theeligami/growschrank/CAD/1_growschrank.png

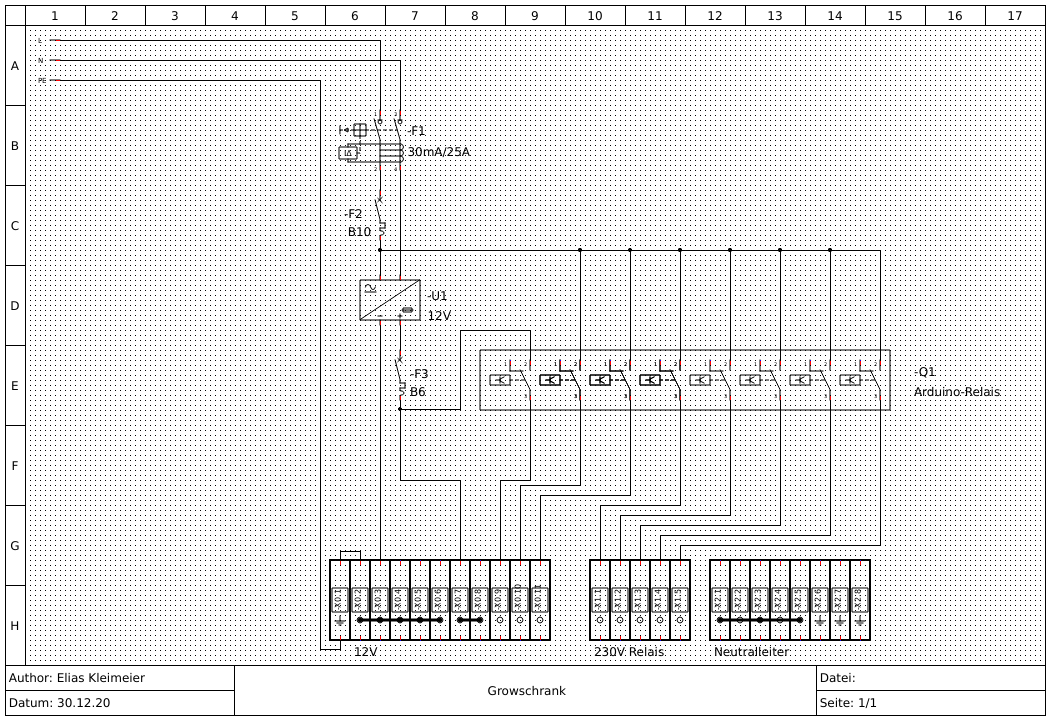
CAD/1_growschrank.png
