theeligami/growschrank/CAD/Zuleitung_Lüfter.FCStd

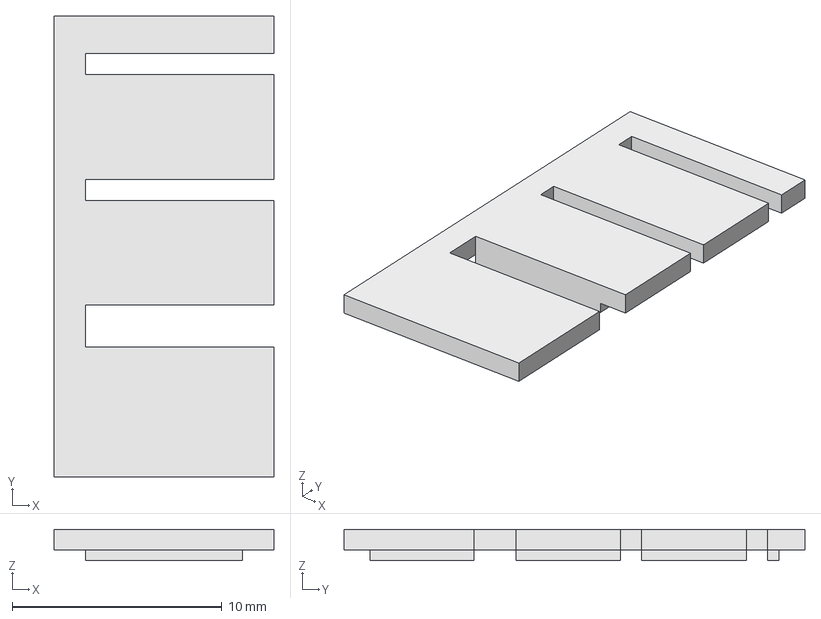
[picture p2: CAD file, 2021-11-26]
CAD/Zuleitung_Lüfter.FCStd
10.5 x 22.0 x 1.50 mm
