theeligami/growschrank/CAD/Pumpenadapter_4mm.FCStd

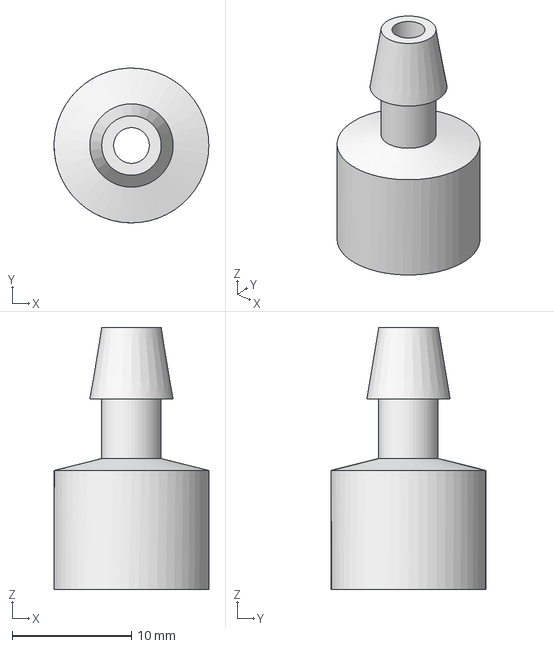
[picture p3: CAD file, 2021-10-30]
CAD/Pumpenadapter_4mm.FCStd
13.0 x 13.0 x 22.0 mm
