theeligami/growschrank/CAD/DINrail_Clip.fcstd

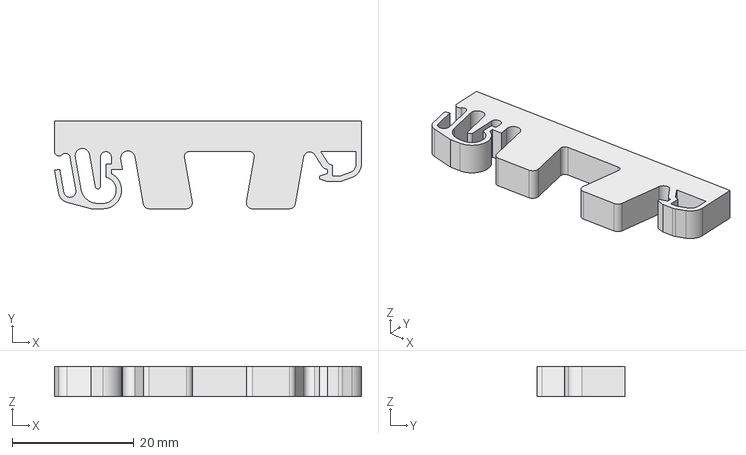
[picture p4: CAD file, 2021-01-07]
CAD/DINrail_Clip.fcstd
50.5 x 14.4 x 5.00 mm
