theeligami/growschrank/CAD/Relais.FCStd

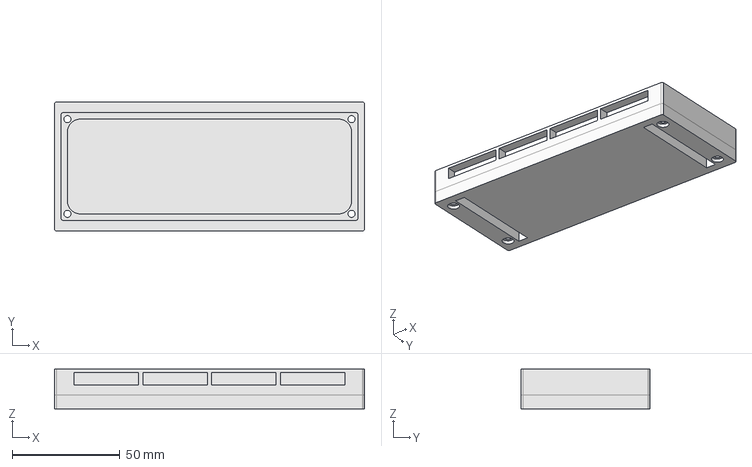
[picture p5: CAD file, 2021-01-07]
CAD/Relais.FCStd
144.0 x 60.0 x 18.5 mm
