theeligami/growschrank/(list of files, cad)

Other CAD files:
CAD/Relais.stl
