theeligami/growschrank/kicad/growschrank.kicad_pcb

## KiCad design kicad/growschrank.kicad_pcb (2021-01-07)

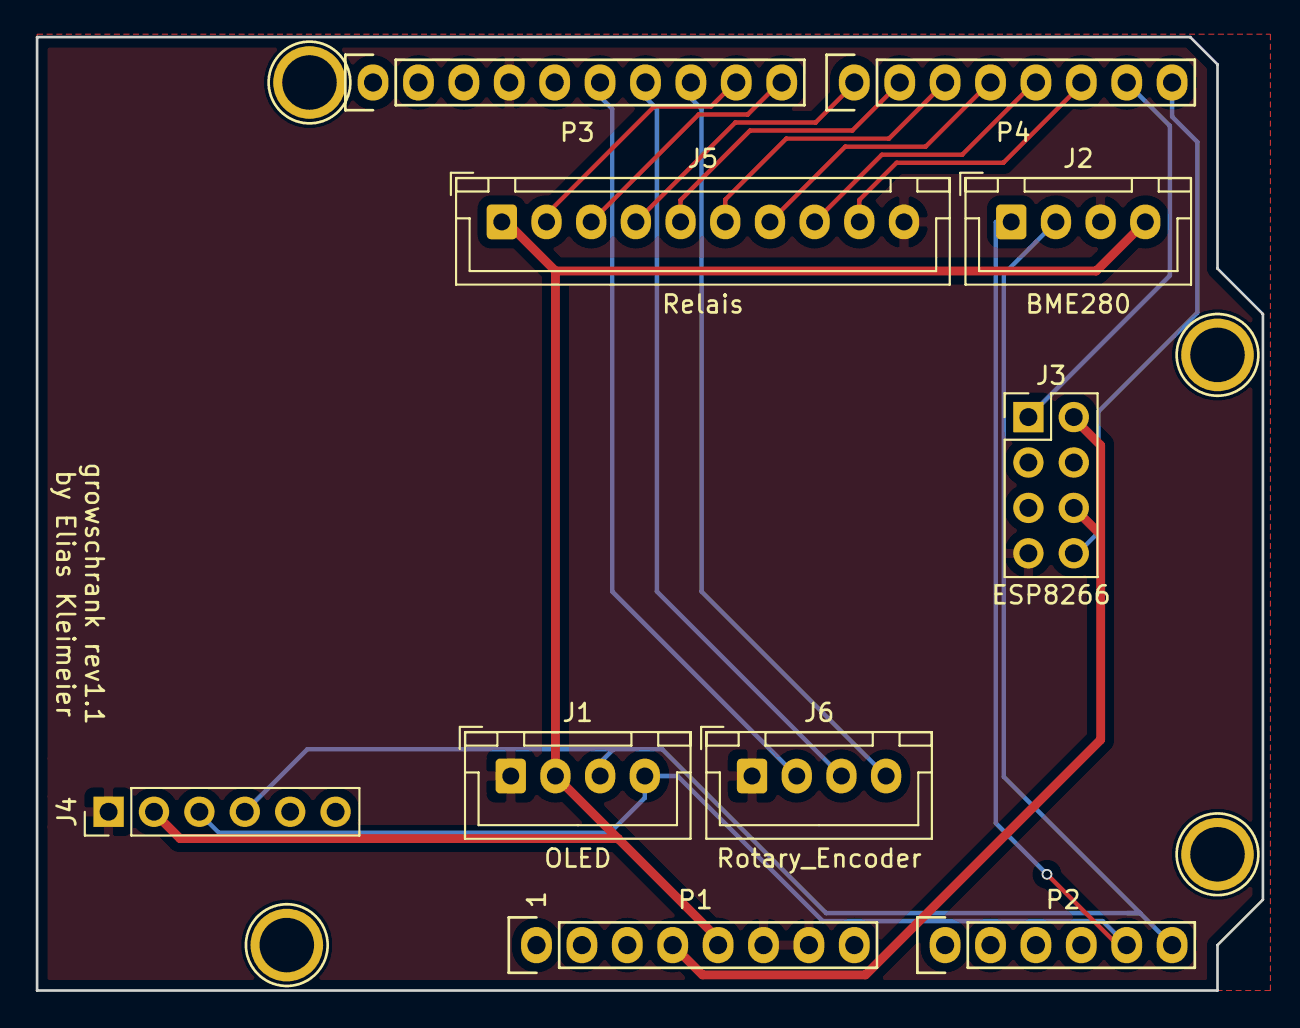
[picture p6: board growschrank.kicad_pcb from above]

Board: 2 copper layers, 68.6 x 53.3 mm, 14 parts (0 on the bottom side), 18 nets.

Parts:
J1: OLED; JST_XH_B4B-XH-A_1x04_P2.50mm_Vertical
J2: BME280; JST_XH_B4B-XH-A_1x04_P2.50mm_Vertical
J3: ESP8266; PinHeader_2x04_P2.54mm_Vertical
J4: DS3231; PinHeader_1x06_P2.54mm_Vertical
J5: Relais; JST_XH_B10B-XH-A_1x10_P2.50mm_Vertical
J6: Rotary_Encoder; JST_XH_B4B-XH-A_1x04_P2.50mm_Vertical
P1: Power; Socket_Strip_Arduino_1x08
P2: Analog; Socket_Strip_Arduino_1x06
P3: Digital; Socket_Strip_Arduino_1x10
P4: Digital; Socket_Strip_Arduino_1x08
P5, P6, P7, P8: CONN_01X01; Arduino_1pin

Connections:
+3V3: J3.2, J3.6, P1.4
+5V: J1.2, J2.4, J4.2, J5.1, P1.5
/0(Rx): J3.8, P4.8
/1(Tx): J3.1, P4.7
/2: J5.9, P4.6
/3(**): J5.8, P4.5
/4: J5.7, P4.4
/5(**): J5.6, P4.3
/6(**): J5.5, P4.2
/7: J5.4, P4.1
/8: J5.3, P3.10
/9(**): J5.2, P3.9
/10(**/SS): J6.4, P3.8
/11(**/MOSI): J6.3, P3.7
/12(MISO): J6.2, P3.6
/A4(SDA): J1.4, J2.1, J4.3, P2.5, P3.2
/A5(SCL): J1.3, J2.2, J4.4, P2.6, P3.1
GND: J1.1, J2.3, J3.7, J4.1, J5.10, J6.1, P1.6, P1.7, P3.4
