theeligami/growschrank/src/growschrank.ino

#include <Adafruit_GFX.h>
#include <Adafruit_SSD1306.h>
#include <Adafruit_Sensor.h>
#include <Adafruit_BME280.h>
#include <avr/sleep.h>
#include <DS3231.h>
#include <EEPROM.h>
#include <Wire.h>
#include <SPI.h>
#include <util/delay.h>

// Relais
#define LAMP 2
#define PUMP 3
#define RELAIS_3 4
#define RELAIS_4 5
#define RELAIS_5 6
#define RELAIS_6 7
#define RELAIS_7 8
#define FAN 9

// Rotary Encoder
#define SW  10
#define CLK  11
#define DT  12

// EEPROM
#define	LAMP_ON_ADR		0
#define LAMP_OFF_ADR	16
#define PUMP_ON_ADR		32
#define PUMP_OFF_ADR	48
#define FAN_ON_ADR		64
#define FAN_OFF_ADR		72
#define LAMP_STATE_ADR  88
#define PUMP_STATE_ADR  104

// OLED
#define SCREEN_WIDTH 128
#define SCREEN_HEIGHT 32
#define CONTRAST 0

#define ON LOW
#define OFF HIGH

Adafruit_SSD1306 display(SCREEN_WIDTH, SCREEN_HEIGHT, &Wire);

// DS3231
DS3231 Clock;
RTClib RTC;

// BME280
Adafruit_BME280 bme;

// Rotary Encoder
volatile int counter = 0;
volatile int currentStateCLK = 0;
volatile int lastStateCLK = 0;
volatile unsigned long lastSW = 0;
volatile boolean up = false, down = false;
volatile boolean swPressed = false;

// Menu
String menuItem0 = "..";	// up
String menuItem1 = "Clock";
String menuItem2 = "Lamp ON/OFF";
String menuItem3 = "Pump ON/OFF";
String menuItem4 = "Fan ON/OFF";
String menuItem5 = "Manual mode";

uint8_t menuItem = 0;
uint8_t subMenuItem = 0;
uint8_t timeItem = 0;
uint8_t page = 0;
uint8_t time[2] = {0,0};
uint8_t lampOn[2], lampOff[2];
uint8_t pumpOn[2], pumpOff[2];
uint8_t fanOn, fanOff;
boolean flag = false;

// Power saving
volatile uint64_t lastAction;
volatile boolean pwrFlag = false;

void setup()
{
  	// Start serial interface
	Serial.begin(9600);
  
  	// Start I2C Interface
  	Wire.begin();

  	// Set display
  	if (!display.begin(SSD1306_SWITCHCAPVCC, 0x3C)) // Address 0x3C for 128x32
  	{
    	Serial.println("SSD1306 allocation failed");
    	while(1);
  	}

  	display.clearDisplay();
  	display.ssd1306_command(SSD1306_SETCONTRAST);
	display.ssd1306_command(CONTRAST);
	display.setTextSize(1);
  	display.setTextColor(WHITE);
  	display.setCursor(0, 0);
  	display.println("Booting...");
  	display.display();

	// Start BME280
	while (!bme.begin(0x76, &Wire))
	{
		display.print("BME280 ERROR at ");
		display.println(bme.sensorID());
		display.display();
		_delay_ms(1000);
	}

	// Set clock to 24h
  	Clock.setClockMode(false);
	
	// Get EEPROM values
	EEPROM.get(LAMP_ON_ADR, lampOn);
	EEPROM.get(LAMP_OFF_ADR, lampOff);
	EEPROM.get(PUMP_ON_ADR, pumpOn);
	EEPROM.get(PUMP_OFF_ADR, pumpOff);
	EEPROM.get(FAN_ON_ADR, fanOn);
	EEPROM.get(FAN_OFF_ADR, fanOff);

	// Pin modes
	pinMode(CLK, INPUT_PULLUP);
  	pinMode(DT, INPUT_PULLUP);
  	pinMode(SW, INPUT_PULLUP);
  	pinMode(LAMP, OUTPUT);
  	pinMode(PUMP, OUTPUT);
  	pinMode(RELAIS_3, OUTPUT);
  	pinMode(RELAIS_4, OUTPUT);
  	pinMode(RELAIS_5, OUTPUT);
  	pinMode(RELAIS_6, OUTPUT);
  	pinMode(RELAIS_7, OUTPUT);
  	pinMode(FAN, OUTPUT);

	for (int i=2; i<9; i++)
		digitalWrite(i, OFF);

  	// Read the initial state of CLK for rotary encoder
  	lastStateCLK = digitalRead(CLK);

	lastAction = millis();

	PCICR |= (1 << PCIE0);
	PCMSK0 |= ((1 << PCINT2) | (1 << PCINT3) | (1 << PCINT4));

	// Set last state of controller e.g. after blackout
	if (EEPROM.read(LAMP_STATE_ADR)==1)
		digitalWrite(LAMP, ON);
	if (EEPROM.read(PUMP_STATE_ADR)==1)
		digitalWrite(PUMP, ON);

	display.setTextSize(1);
}

void loop()
{
	if (millis()-lastAction>=60000)
	{
		if (!pwrFlag)
			pwrFlag = true;
			display.clearDisplay();
			display.display();
	}
	else
	{
		drawMenu();
		readEncoder();
	}

	checkTimer(lampOn, lampOff, LAMP, LAMP_STATE_ADR);
	checkOnOffController(fanOn, fanOff, (uint8_t) bme.readHumidity(), FAN);
	_delay_ms(10);
}

// Draws the menu to the screen
void drawMenu()
{
	switch (page)
	{
		case 0:	// Main menu
		{
			displayMainMenuPage();
			break;
		}
		case 1:	// Settings selection menu
		{
			display.setTextSize(1);
			display.clearDisplay();
			display.setTextColor(WHITE);
			display.setCursor(0, 0);
			display.print("Main Menu");
			display.drawFastHLine(0, 10, SCREEN_WIDTH, WHITE);
			switch (menuItem)
			{
				case 0:
				{
					displayMenuItem(menuItem0, 15, true);
					displayMenuItem(menuItem1, 25, false);
					break;
				}
				case 1:
				{
					displayMenuItem(menuItem0, 15, false);
					displayMenuItem(menuItem1, 25, true);
					break;
				}
				case 2:
				{
					displayMenuItem(menuItem1, 15, false);	
					displayMenuItem(menuItem2, 25, true);
					break;
				}
				case 3:
				{
					displayMenuItem(menuItem2, 15, false);
					displayMenuItem(menuItem3, 25, true);
					break;
				}
				case 4:
				{
					displayMenuItem(menuItem3, 15, false);
					displayMenuItem(menuItem4, 25, true);
					break;
				}
				case 5:
				{
					displayMenuItem(menuItem4, 15, false);
					displayMenuItem(menuItem5, 25, true);
					break;
				}
			}
			display.display();
			break;
		}
		case 2:
		{
			switch (menuItem)
			{
				case 1:	// Clock
				{
					displayClockMenuPage(menuItem1, time);
					break;
				}
				case 2:	// Lamp time
				{
					if (!flag)
					{
						flag = true;
						EEPROM.get(LAMP_ON_ADR, lampOn);
						EEPROM.get(LAMP_OFF_ADR, lampOff);
					}
					displayTimerMenuPage(menuItem2, lampOn, lampOff);
					break;
				}
				case 3:	// Pump time
				{
					if (!flag)
					{
						flag = true;
						EEPROM.get(PUMP_ON_ADR, pumpOn);
						EEPROM.get(PUMP_OFF_ADR, pumpOff);
					}
					displayTimerMenuPage(menuItem3, pumpOn, pumpOff);
					break;
				}
				case 4:	// Fan controller
				{
					if (!flag)
					{
						flag = true;
						EEPROM.get(FAN_ON_ADR, fanOn);
						EEPROM.get(FAN_OFF_ADR, fanOff);
					}
					displayOnOffControllerMenuPage(menuItem4, fanOn, fanOff);
					break;
				}
				case 5:	// Manual control
				{
					displayManualControl(menuItem5);
					break;
				}
			}
			break;
		}
	}
}

// Handles encoder input
void readEncoder()
{
	if (up)		// Encoder turned UP
	{
		up = false;
		switch (page)
		{
			case 1:	// Menu list
			{
				if (menuItem > 0)
					--menuItem;
				break;
			}
			case 2:	// Settings
			{
				switch (menuItem)
				{
					case 1:	// Clock
					{
						if (timeItem==0)
						{
							if (time[0]>0)
								--time[0];
							else
								time[0] = 23;
						}
						else if (timeItem==1)
						{
							if (time[1]>0)
								--time[1];
							else
								time[1] = 59;
						}
						break;
					}
					case 2:	// Lamp
					{
						upTimerMenu(lampOn, lampOff, subMenuItem, timeItem);
						break;
					}
					case 3:	// Pump
					{
						upTimerMenu(pumpOn, pumpOff, subMenuItem, timeItem);
						break;
					}
					case 4:	// Fan
					{
						if (subMenuItem==0)
						{
							if (fanOn>71)
								--fanOn;
						}
						else
							if (fanOff>0)
								--fanOff;
						break;
					}
					case 5:	// Manual control
					{
						if (subMenuItem>0)
							--subMenuItem;
						break;
					}
				}
				break;
			}
		}
	}
	else if (down)	// Encoder turned DOWN
	{
		down = false;
		switch (page)
		{
			case 1:	// Menu list
			{
				if (menuItem < 5)
					++menuItem;
				break;
			}
			case 2:	// Settings
			{
				switch (menuItem)
				{
					case 1:	// Clock
					{
						if (timeItem==0)
						{
							if (time[0]<23)
								++time[0];
							else
								time[0] = 0;
						}
						else if (timeItem==1)
						{
							if (time[1]<59)
								++time[1];
							else
								time[0] = 0;
						}
						break;
					}
					case 2:	// Lamp
					{
						downTimerMenu(lampOn, lampOff, subMenuItem, timeItem);
						break;
					}
					case 3:	// Pump
					{
						downTimerMenu(pumpOn, pumpOff, subMenuItem, timeItem);
						break;
					}
					case 4:	// Fan
					{
						if (subMenuItem==0)
						{
							if (fanOn<100)
								++fanOn;
						}
						else
							if (fanOff<70)
								++fanOff;
						break;
					}
					case 5:	// Manual control
					{
						if (subMenuItem<3)
							++subMenuItem;
						break;
					}
				}
				break;
			}
		}
	}
	else if (swPressed)	// Encoder switch pressed
	{
		swPressed = false;
		switch (page)
		{
			case 0:	// Main menu
			{
				++page;
				break;
			}
			case 1:	// Menu list
			{
				if (menuItem==0)
					--page;
				else
				{
					if (menuItem==1)
					{
						time[0] = RTC.now().hour();
						time[1] = RTC.now().minute();
					}
					++page;
				}
				break;
			}
			case 2:	// Settings
			{
				switch (menuItem)
				{
					case 1:	// Clock
					{
						if (timeItem==0)
							++timeItem;
						else
						{
							timeItem = 0;
							page = 1;
							Clock.setHour(time[0]);
							Clock.setMinute(time[1]);
						}
						break;
					}
					case 2:	// Lamp
					case 3:	// Pump
					{
						if (subMenuItem==0)
						{
							if (timeItem==0)
								++timeItem;
							else if (timeItem==1)
							{
								timeItem = 0;
								++subMenuItem;
							}
						}
						else if (subMenuItem==1)
						{
							if (timeItem==0)
								++timeItem;
							else if (timeItem==1)
							{
								if (menuItem==2)
								{
									EEPROM.put(LAMP_ON_ADR, lampOn);
									EEPROM.put(LAMP_OFF_ADR, lampOff);
								}
								else
								{
									EEPROM.put(PUMP_ON_ADR, pumpOn);
									EEPROM.put(PUMP_OFF_ADR, pumpOff);
								}
								timeItem = 0;
								subMenuItem = 0;
								page = 1;
								flag = false;
							}
						}
						break;
					}
					case 4:	// Fan
					{
						if (subMenuItem==0)
							++subMenuItem;
						else 
						{
							EEPROM.put(FAN_ON_ADR, fanOn);
							EEPROM.put(FAN_OFF_ADR, fanOff);
							subMenuItem = 0;
							page = 1;
							flag = false;
						}
						break;
					}
					case 5: // Manual control
					{
						switch (subMenuItem)
						{
							case 0:	// Back
							{
								--page;
								break;
							}
							case 1:	// Lamp
							{
								digitalWrite(LAMP, !digitalRead(LAMP));
								EEPROM.put(LAMP_STATE_ADR, !digitalRead(LAMP));
								break;
							}
							case 2:	// Pump
							{
								digitalWrite(PUMP, !digitalRead(PUMP));
								EEPROM.put(PUMP_STATE_ADR, !digitalRead(PUMP));
								break;
							}
							case 3:	// Fan
							{
								digitalWrite(FAN, !digitalRead(FAN));
								break;
							}
						}
					}
				}
			}
		}
	}
}

// Draw menu items in menu selection
void displayMenuItem(String item, uint8_t pos, boolean selected)
{
	if (selected)
		display.setTextColor(BLACK, WHITE);
	else
		display.setTextColor(WHITE, BLACK);
	display.setCursor(0, pos);
	display.print(">"+item);
}

void displayMenuItemStatus(String item, uint8_t pos, boolean selected, uint8_t pin)
{
	displayMenuItem(item, pos, selected);
	display.print(" ");
	display.print(!digitalRead(pin));
}

// Main menu
void displayMainMenuPage()
{
	display.setTextSize(2);
	display.clearDisplay();
	display.setCursor(35, 0);
	display.print(timeToString(RTC.now().hour()));
	display.print(':');
	display.println((timeToString(RTC.now().minute())));
	display.setTextSize(1);
	display.setCursor(35, 15);
	display.print((uint8_t) bme.readTemperature());
	display.print("C    ");
	display.print((uint8_t) bme.readHumidity());
	display.println("%");
	display.print("Lamp:");
	display.print(!digitalRead(LAMP));
	display.print(" Pump:");
	display.print(!digitalRead(PUMP));
	display.print(" Fan:");
	display.println(!digitalRead(FAN));
	display.display();
}

// Draw timer settings
void displayTimerMenuPage(String menuItem, uint8_t onTime[2], uint8_t offTime[2])
{
	display.setTextSize(1);
	display.clearDisplay();
	display.setTextColor(WHITE);
	display.setCursor(0, 0);
	display.print(menuItem); display.drawFastHLine(0, 10, SCREEN_WIDTH, WHITE);
	display.setCursor(0, 15);

	if (subMenuItem==0)	// On time
	{
		display.setTextColor(WHITE, BLACK);
		display.print("On:  ");
		
		if (timeItem==0)
		{
			display.setTextColor(BLACK, WHITE);
			display.print(timeToString(onTime[0]));
			display.setTextColor(WHITE, BLACK);
			display.print(':');
			display.println(timeToString(onTime[1]));

		}
		else
		{
			display.print(timeToString(onTime[0]));
			display.print(':');
			display.setTextColor(BLACK, WHITE);
			display.println(timeToString(onTime[1]));
		}
		display.setTextColor(WHITE, BLACK);
		display.print("Off: ");
		display.print(timeToString(offTime[0]));
		display.print(':');
		display.println(timeToString(offTime[1]));
	}
	else 
	{
		display.setTextColor(WHITE, BLACK);
		display.print("On:  ");
		display.print(timeToString(onTime[0]));
		display.print(':');
		display.println(timeToString(onTime[1]));
		display.print("Off: ");

		if (timeItem==0)
		{
			display.setTextColor(BLACK, WHITE);
			display.print(timeToString(offTime[0]));
			display.setTextColor(WHITE, BLACK);
			display.print(':');
			display.println(timeToString(offTime[1]));
		}
		else
		{
			display.setTextColor(WHITE, BLACK);
			display.print(timeToString(offTime[0]));
			display.print(':');
			display.setTextColor(BLACK, WHITE);
			display.println(timeToString(offTime[1]));
		}
	}
	display.display();
}

// Draw clock settings
void displayClockMenuPage(String menuItem, uint8_t time[2])
{
	display.setTextSize(1);
	display.clearDisplay();
	display.setTextColor(WHITE);
	display.setCursor(0, 0);
	display.print(menuItem);
	display.drawFastHLine(0, 10, SCREEN_WIDTH, WHITE);
	display.setTextSize(2);
	display.setCursor(0, 15);
	if (timeItem==0)	// Hour
	{
		display.setTextColor(BLACK, WHITE);
		display.print(timeToString(time[0]));

		display.setTextColor(WHITE, BLACK);
		display.print(":");
		display.print(timeToString(time[1]));
	}
	else	// Minute
	{
		display.setTextColor(WHITE, BLACK);
		display.print(timeToString(time[0]));
		display.print(":");

		display.setTextColor(BLACK, WHITE);
		display.print(timeToString(time[1]));
	}
	display.display();
}

// Draw on-off controller settings
void displayOnOffControllerMenuPage(String menuItem, uint8_t onValue, uint8_t offValue)
{
	display.setTextSize(1);
	display.clearDisplay();
	display.setTextColor(WHITE);
	display.setCursor(0, 0);
	display.print(menuItem);
	display.drawFastHLine(0, 10, SCREEN_WIDTH, WHITE);
	display.setCursor(0, 15);
	if (subMenuItem==0) // On condition
	{
		display.setTextColor(BLACK, WHITE);
		display.print("On:  ");
		display.println(onValue);
		
		display.setTextColor(WHITE, BLACK);
		display.print("Off: ");
		display.println(offValue);
	}
	else // Off condition
	{
		display.print("On:  ");
		display.println(onValue);
		
		display.setTextColor(BLACK, WHITE);
		display.print("Off: ");
		display.println(offValue);
	}
	display.display();
}

// Draw manual control menu
void displayManualControl(String menuItem)
{
	display.setTextSize(1);
	display.clearDisplay();
	display.setTextColor(WHITE);
	display.setCursor(0, 0);
	display.print(menuItem);
	display.drawFastHLine(0, 10, SCREEN_WIDTH, WHITE);
	display.setCursor(0, 15);
	
	switch (subMenuItem)
	{
		case 0:
		{
			displayMenuItem(menuItem0, 15, true);
			displayMenuItemStatus(menuItem2, 25, false, LAMP);
			break;
		}
		case 1:
		{
			displayMenuItemStatus(menuItem2, 15, true, LAMP);
			displayMenuItemStatus(menuItem3, 25, false, PUMP);
			break;
		}
		case 2:
		{
			displayMenuItemStatus(menuItem3, 15, true, PUMP);
			displayMenuItemStatus(menuItem4, 25, false, FAN);
			break;
		}
		case 3:
		{
			displayMenuItemStatus(menuItem3, 15, false, PUMP);
			displayMenuItemStatus(menuItem4, 25, true, FAN);
			break;
		}
	}
	display.display();
}

// Handle encoder up-input for timer
void upTimerMenu(uint8_t on[2], uint8_t off[2], uint8_t subMenu, uint8_t time)
{
	if (subMenu==0)
	{
		if (time==0)
		{
			if (on[0]>0)
				--on[0];
			else
				on[0] = 23;
		}
		else
		{
			if (on[1]>0)
				--on[1];
			else
				on[1] = 59;
		}
	}
	else 
	{
		if (time==0)
		{
			if (off[0]>0)
				--off[0];
			else
				off[0] = 23;
		}
		else
		{
			if (off[1]>0)
				--off[1];
			else
				off[1] = 59;
		}
	}
}

// Handle encoder down-input for timer
void downTimerMenu(uint8_t on[2], uint8_t off[2], uint8_t subMenu, uint8_t time)
{
	if (subMenu==0)
	{
		if (time==0)
		{
			if (on[0]<23)
				++on[0];
			else
				on[0] = 0;
		}
		else
		{
			if (on[1]<59)
				++on[1];
			else
				on[1] = 0;
		}
	}
	else
	{
		if (time==0)
		{
			if (off[0]<23)
				++off[0];
			else
				off[0] = 0;
		}
		else
		{
			if (off[1]<59)
				++off[1];
			else
				off[1] = 0;
		}
	}
}

// Turns timers on and off
void checkTimer(uint8_t on[2], uint8_t off[2], uint8_t pin, uint8_t adr)
{
	if (on[0]==RTC.now().hour() && on[1]==RTC.now().minute())
	{
		digitalWrite(pin, ON);
		EEPROM.put(adr, 1);
	}
	else if (off[0]==RTC.now().hour() && off[1]==RTC.now().minute())
	{
		digitalWrite(pin, OFF);
		EEPROM.put(adr, 0);
	}
}

// Turns on-off controllers on and off
void checkOnOffController(uint8_t on, uint8_t off, uint8_t value, uint8_t pin)
{	
	if (value>=on)
		digitalWrite(pin, ON);
	else if (value<=off)
		digitalWrite(pin, OFF);
}

// Convert a time (hour or minute) to a string
const String timeToString(uint8_t time)
{
	static char string[2];
	sprintf(string, "%02d", time);
	return string;
}

// Encoder interrupt
ISR(PCINT0_vect)
{
	if (!swPressed)
	{
  		cli();
		lastAction = millis();
		pwrFlag = false;

		if (!digitalRead(SW))
		{
			if ((millis()-lastSW)>150)	// Debounce
			{
				swPressed = true;
				lastSW = millis();
			}
		}
		else
		{
			// Read the current state of CLK
  			currentStateCLK = digitalRead(CLK);
  			// If last and current state of CLK are different, then pulse occurred
  			// React to only 1 state change to avoid double count
  			if (currentStateCLK != lastStateCLK  && currentStateCLK == 1)
  			{

    			// If the DT state is different than the CLK state then
    			// the encoder is rotating CCW so decrement
    			if (digitalRead(DT) != currentStateCLK)
				{
					up = true;
					down = false;
				}
    			else	// Encoder is rotating CW so increment
				{
					up = false;
					down = true;
				}
  			}
			// Remember last CLK state
			lastStateCLK = currentStateCLK;
		}
		sei();
	}
}
