theeligami/growschrank/(commit log)

2020-12-16 Added test stuff and interrupt vector
2020-12-20 Added timer functionality.
2020-12-21 Fixed power supply of BME280
    [growschrank.kicad_pcb, growschrank.sch]
2020-12-22 GY-BME280 is 3.3V-5V fuck this shit
    [growschrank.kicad_pcb, growschrank.sch]
2020-12-30 Changed relais connector
    [growschrank.kicad_pcb, growschrank.sch]
2020-12-30 Added plans for wiring
2021-01-07 Added DIN Rail case for relais
    [DINrail_Clip.fcstd, Relais.FCStd, Relais.stl]
2021-01-07 Added more space for clock
    [growschrank.kicad_pcb]
2021-01-31 Moved to CAD
2021-04-16 Adjustments because relay is active low
2021-04-23 Added pin status to manual control
2021-09-16 Relays now remember state during blackout (if triggered automatically, manual mode is not affected)
2021-10-30 Adapter für Pumpe in Bewässerung hinzugefügt
    [Pumpenadapter_4mm.FCStd]
2021-11-26 Adapter für Lüfterzuleitung
    [Zuleitung_Lüfter.FCStd]
